Arrakark/BrightBoard/BOM Optimization.ods

 |  |  |  | Prototype |  | 100 Units
Quantity | Part Name | Manufacturer Part Number | Description | Unit Price | Extended Price | Replacement Part Number | Part Name | Unit Price | Extended Price | Purchase URL
56 | JE2835AWT-00-0000-000A0HG830ECT-ND | JE2835AWT-00-0000-000A0HG830E | CREE J SERIES JE2835 LIGHT EMITT | 0.042 | 2.352 | - | - | 0.02739 | 1.53384
56 | JE2835AWT-00-0000-000A0UF965ECT-ND | JE2835AWT-00-0000-000A0UF965E | CREE J SERIES JE2835 LIGHT EMITT | 0.043 | 2.408 | - | - | 0.02793 | 1.56408
3 | 399-9155-1-ND | C0805C104K9RACTU | CAP CER 0.1UF 6.3V X7R 0805 | 0.24 | 0.72 | C0805C104K5RACTU | CAP CER 0.1UF 50V X7R 0805 | 0.0020833 | 0.0062499 | https://www.ebay.com/itm/12-000pcs-3-Reels-KEMET-C0805C104K5RACTU-CAP-CER-0-1UF-50V-X7R-0805-ji-7c/273997252677
2 | 1276-2450-1-ND | CL21B104MBCNNNC | CAP CER 0.1UF 50V X7R 0805 | 0.041 | 0.082 | C0805C104K5RACTU | CAP CER 0.1UF 50V X7R 0805 | 0.0020833 | 0.0041666 | https://www.ebay.com/itm/12-000pcs-3-Reels-KEMET-C0805C104K5RACTU-CAP-CER-0-1UF-50V-X7R-0805-ji-7c/273997252677
1 | 490-14642-1-ND | GRM219C8YA225KE15D | CAP CER 2.2UF 35V X6S 0805 | 0.21 | 0.21 | GMK316B7225KLHT | CAP CER 2.2UF 35V X7R 1206 | 0.1286 | 0.1286 | https://www.digikey.ca/product-detail/en/taiyo-yuden/GMK316B7225KLHT/587-3370-1-ND/4157502
1 | 732-4986-1-ND | 150080VS75000 | LED GREEN CLEAR 0805 SMD | 0.17 | 0.17 | DNP | DNP | 0 | 0
1 | 609-3695-1-ND | 20021121-00010C4LF | CONN HEADER SMD 10POS 1.27MM | 0.84 | 0.84 | DNP | DNP | 0 | 0
1 | CP-102AH-ND | PJ-102AH | CONN PWR JACK 2X5.5MM SOLDER | 0.76 | 0.76 | - | - | 0.5428 | 0.5428
1 | 587-5797-1-ND | NRS5010T100MMGF | INDUCTOR SMD POWER, 10 UH20 %, T | 0.32 | 0.32 |  |  | 0.32 | 0.32
2 | DMN3404LDICT-ND | DMN3404L-7 | MOSFET N-CH 30V 5.8A SOT-23 | 0.39 | 0.78 |  |  | 0.39 | 0.78
1 | RNCP0805FTD1K00CT-ND | RNCP0805FTD1K00 | RES 1K OHM 1% 1/4W 0805 | 0.072 | 0.072 |  |  | 0.072 | 0.072
2 | A130471CT-ND | CRGP0805F330R | CRGP 0805 330R 1% | 0.22 | 0.44 |  |  | 0.22 | 0.44
1 | 296-41856-1-ND | TPS62177DQCR | IC REG BUCK 3.3V 500MA 10WSON | 1.65 | 1.65 |  |  | 1.65 | 1.65
2 | 1276-6170-1-ND | RUT2012FR100CS | RES 0.1 OHM 1% 1/4W 0805 | 0.3 | 0.6 |  |  | 0.3 | 0.6
3 | RMCF0805FT10K0CT-ND | RMCF0805FT10K0 | RES 10K OHM 1% 1/8W 0805 | 0.027 | 0.081 |  |  | 0.027 | 0.081
1 | RHM18BCCT-ND | MCR100JZHJ180 | RES SMD 18 OHM 5% 1W 2512 | 0.27 | 0.27 |  |  | 0.27 | 0.27
2 | RMCF0805FT100KCT-ND | RMCF0805FT100K | RES 100K OHM 1% 1/8W 0805 | 0.027 | 0.054 |  |  | 0.027 | 0.054
4 | 1276-2405-1-ND | CL21A106KQCLRNC | CAP CER 10UF 6.3V X5R 0805 | 0.085 | 0.34 |  |  | 0.085 | 0.34
1 | E73-2G4M04S1B | E73-2G4M04S1B | NRF52832 E73-2G4M04S Bluetooth module | 3.1 | 3.1 | - | - | 2.7 | 2.7
1 | - | - | 24V 3A Power Supply (Generic, 5.5x2.1mm Plug) | 9.39 | 9.39 |  |  | 9.39 | 9.39
1 | PCB | PCB | JLCPCB (Order of 10) | 5.238 | 5.238 | - | - | 5 | 5
1 | Plastic Shroud |  |  | 0 | 0 |  |  |  | 0
8 | M4 Nut |  |  | 0 | 0 |  |  |  | 0
8 | M4 Bolt |  |  | 0 | 0 |  |  |  | 0
1 | Baseplate |  |  | 0 | 0 |  |  |  | 0
1 | Tripod Tilt Adapter |  |  | 0 | 0 |  |  |  | 0
1 | Tripod |  |  | 0 | 0 |  |  |  | 0
 |  |  |  | Cost per board | 29.877 |  |  | Cost per board | 25.4767365
