Arrakark/BrightBoard/BrightBoard1/CUI_PJ-102A.step

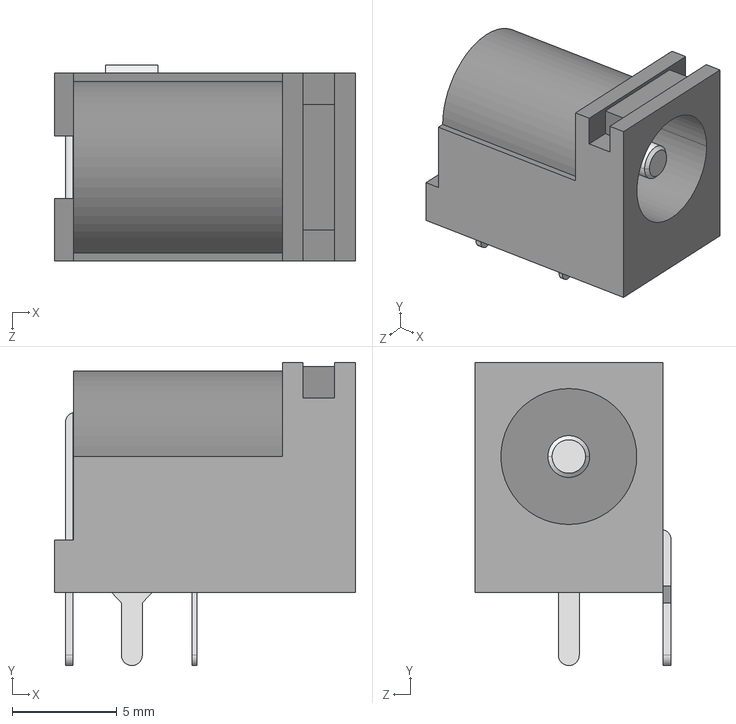
[picture p1: CAD file, 2019-09-11]
BrightBoard1/CUI_PJ-102A.step
14.4 x 14.5 x 9.40 mm
