Arrakark/BrightBoard/BrightBoard1/BrightBoard1.step

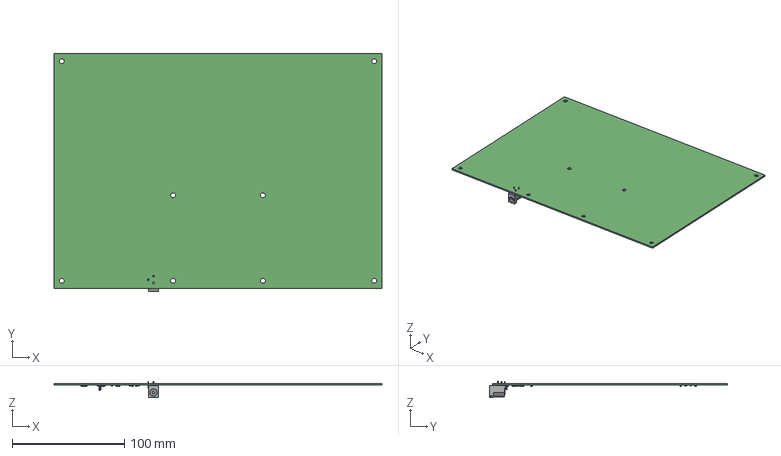
[picture p2: CAD file, 2019-09-11]
BrightBoard1/BrightBoard1.step
292.1 x 212.2 x 14.5 mm
