Arrakark/BrightBoard/BrightBoard1/BrightBoard1.kicad_pcb

## KiCad design BrightBoard1/BrightBoard1.kicad_pcb (2019-09-11)

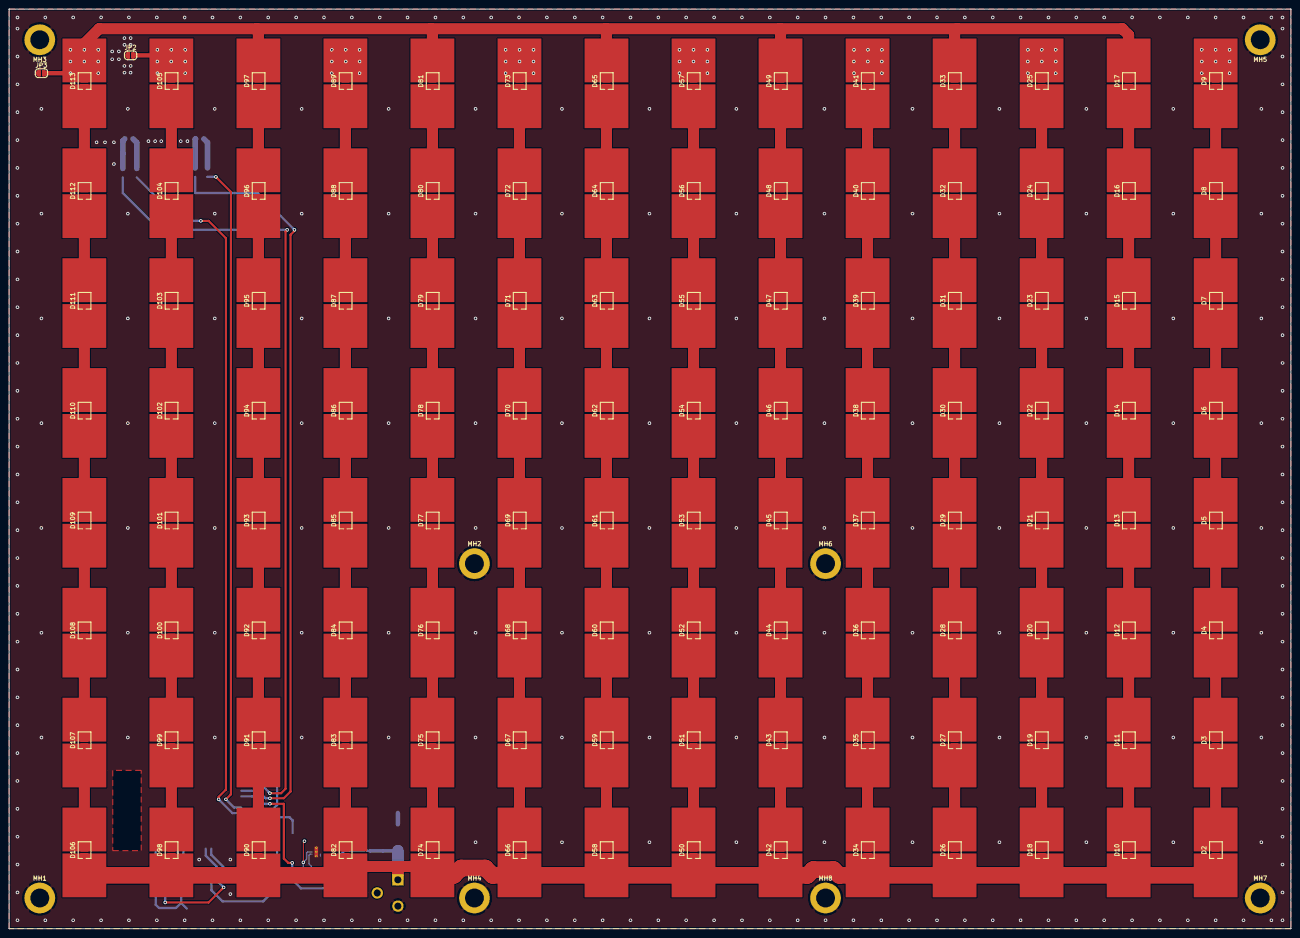
[picture p3: board BrightBoard1.kicad_pcb from above]

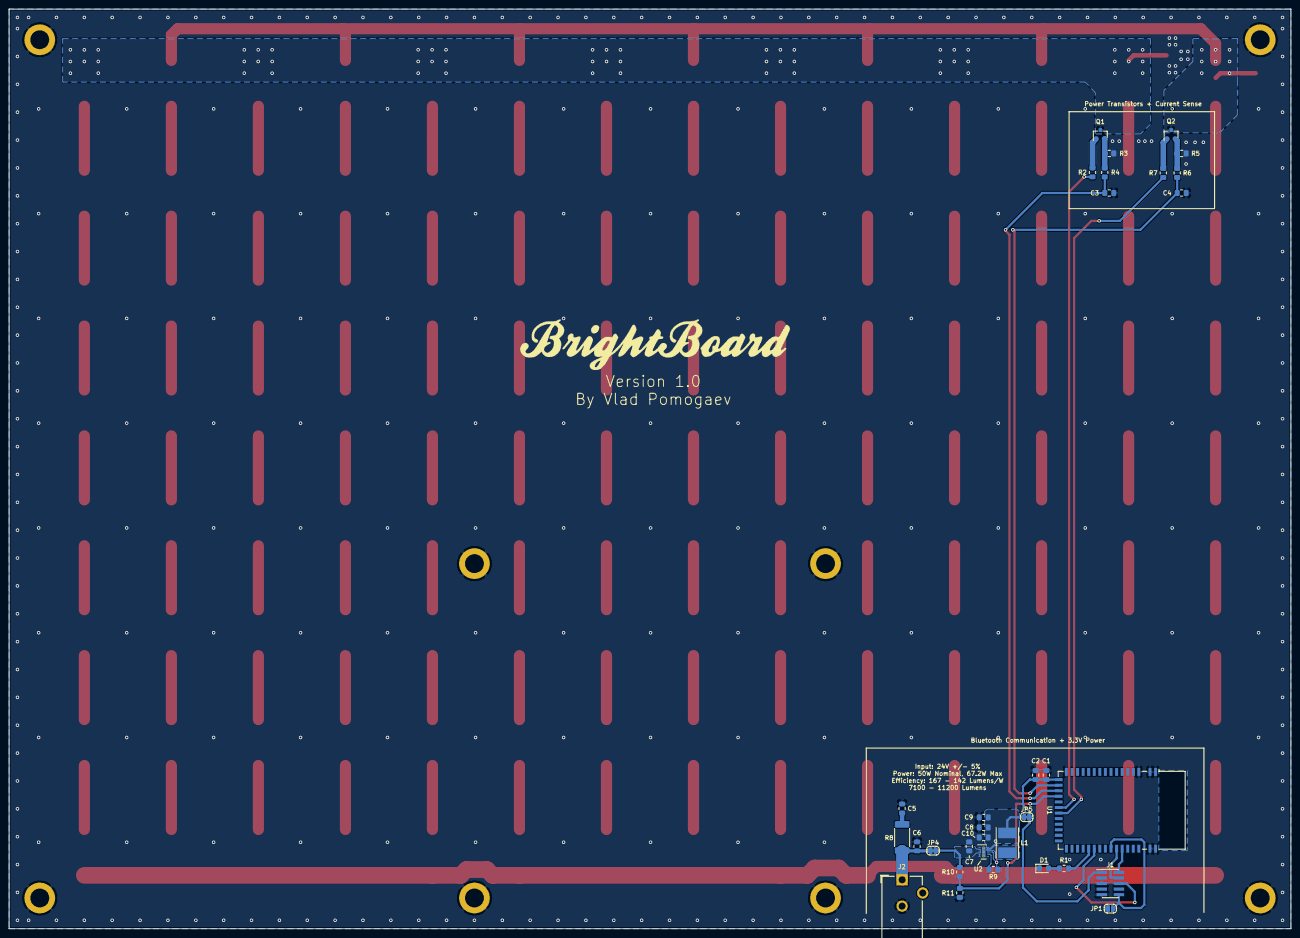
[picture p4: board BrightBoard1.kicad_pcb from below]

Board: 2 copper layers, 292.1 x 209.6 mm, 154 parts (32 on the bottom side), 123 nets.

Parts:
C1, C8, C9, C10: 10uF 6.3V; C_0805_2012Metric_Pad1.15x1.40mm_HandSolder
C2, C3, C4: 100nF 6.3V; C_0805_2012Metric_Pad1.15x1.40mm_HandSolder
C5, C6: 100nF 30V; C_0805_2012Metric_Pad1.15x1.40mm_HandSolder
C7: 2.2uF 30V; C_0805_2012Metric_Pad1.15x1.40mm_HandSolder
D1: GREEN_LED; LED_0805_2012Metric_Pad1.15x1.40mm_HandSolder
D2, D3, D4, D5, D6, D7, D8, D9, D18, D19, D20, D21, D22, D23, D24, D25, D34, D35, D36, D37, D38, D39, D40, D41, D50, D51, D52, D53, D54, D55, D56, D57, D66, D67, D68, D69, D70, D71, D72, D73, D82, D83, D84, D85, D86, D87, D88, D89, D98, D99, D100, D101, D102, D103, D104, D105: LED_1; 2835_LED
D10, D11, D12, D13, D14, D15, D16, D17, D26, D27, D28, D29, D30, D31, D32, D33, D42, D43, D44, D45, D46, D47, D48, D49, D58, D59, D60, D61, D62, D63, D64, D65, D74, D75, D76, D77, D78, D79, D80, D81, D90, D91, D92, D93, D94, D95, D96, D97, D106, D107, D108, D109, D110, D111, D112, D113: LED_2; 2835_LED
J1: Conn_ARM_JTAG_SWD_10; PinHeader_2x05_P1.27mm_Vertical_SMD
J2: VIN_JACK; BarrelJack_CUI_PJ-102AH_Horizontal
JP1: RESET; SolderJumper-2_P1.3mm_Open_RoundedPad1.0x1.5mm
JP2: STRIP_1_BYPASS; SolderJumper-2_P1.3mm_Open_RoundedPad1.0x1.5mm
JP3: STRIP_2_BYPASS; SolderJumper-2_P1.3mm_Open_RoundedPad1.0x1.5mm
JP4: IN_JUMPER; SolderJumper-2_P1.3mm_Bridged_RoundedPad1.0x1.5mm
JP5: OUT_JUMPER; SolderJumper-2_P1.3mm_Bridged_RoundedPad1.0x1.5mm
L1: 10uH 124mOhm; L_Taiyo-Yuden_NR-50xx_HandSoldering
MH1, MH2, MH3, MH4, MH5, MH6, MH7, MH8: M4; MountingHole_4.3mm_M4_ISO14580_Pad
Q1, Q2: DMN3404L; SOT-23
R1: 1k00; R_0805_2012Metric_Pad1.15x1.40mm_HandSolder
R2, R7: 330R; R_0805_2012Metric_Pad1.15x1.40mm_HandSolder
R3, R5: 0R10; R_0805_2012Metric_Pad1.15x1.40mm_HandSolder
R4, R6, R11: 10K0; R_0805_2012Metric_Pad1.15x1.40mm_HandSolder
R8: 18R 1W; R_2512_6332Metric_Pad1.52x3.35mm_HandSolder
R9: 100k; R_0805_2012Metric_Pad1.15x1.40mm_HandSolder
R10: 100K; R_0805_2012Metric_Pad1.15x1.40mm_HandSolder
U1: E73-2G4M04S-52832; E73-2G4M04S
U2: TPS62177DQC; WSON-10-1EP_2x3mm_P0.5mm_EP0.84x2.4mm_ThermalVias

Connections:
+3V3: C1.1, C2.1, J1.1, JP5.2, U1.16
/HEARTBEAT: R1.1, U1.32
/LEDs/STRIP_1_RETURN: D9.1, D25.1, D41.1, D57.1, D73.1, D89.1, D105.1, JP2.2, Q1.3
/LEDs/STRIP_2_RETURN: D17.1, D33.1, D49.1, D65.1, D81.1, D97.1, D113.1, JP3.2, Q2.3
/STRIP_1_AI: C3.1, R4.1, U1.18
/STRIP_1_EN: R2.2, U1.21
/STRIP_2_AI: C4.1, R6.1, U1.17
/STRIP_2_EN: R7.2, U1.22
/SWDCLK: J1.4, U1.37
/SWDIO: J1.2, U1.38
/TRACEDATA[0]: J1.6, U1.33
/VCC_AI: R10.2, R11.1, U1.19
/~RESET: J1.10, JP1.2, U1.36
GND: C1.2, C2.2, C3.2, C4.2, C5.2, C6.2, C7.2, C8.2, C9.2, C10.2, D1.1, J1.3, J1.5, J1.9, J2.2, JP1.1, JP2.1, JP3.1, MH1.1, MH2.1, MH3.1, MH4.1, MH5.1, MH6.1, MH7.1, MH8.1, R3.2, R5.2, R11.2, U1.0, U1.1, U1.2, U1.15, U1.42, U1.43, U2.1, U2.4, U2.5, U2.6, U2.11
unnamed: C5.1, R8.2
unnamed: C7.1, JP4.2, R10.1, U2.2, U2.3
unnamed: C8.1, C9.1, C10.1, JP5.1, L1.2, R9.1, U2.8, U2.10
unnamed: D1.2, R1.2
unnamed: D2.1, D3.2
unnamed: D3.1, D4.2
unnamed: D4.1, D5.2
unnamed: D5.1, D6.2
unnamed: D6.1, D7.2
unnamed: D7.1, D8.2
unnamed: D8.1, D9.2
unnamed: D10.1, D11.2
unnamed: D11.1, D12.2
unnamed: D12.1, D13.2
unnamed: D13.1, D14.2
unnamed: D14.1, D15.2
unnamed: D15.1, D16.2
unnamed: D16.1, D17.2
unnamed: D18.1, D19.2
unnamed: D19.1, D20.2
unnamed: D20.1, D21.2
unnamed: D21.1, D22.2
unnamed: D22.1, D23.2
unnamed: D23.1, D24.2
unnamed: D24.1, D25.2
unnamed: D26.1, D27.2
unnamed: D27.1, D28.2
unnamed: D28.1, D29.2
unnamed: D29.1, D30.2
unnamed: D30.1, D31.2
unnamed: D31.1, D32.2
unnamed: D32.1, D33.2
unnamed: D34.1, D35.2
unnamed: D35.1, D36.2
unnamed: D36.1, D37.2
unnamed: D37.1, D38.2
unnamed: D38.1, D39.2
unnamed: D39.1, D40.2
unnamed: D40.1, D41.2
unnamed: D42.1, D43.2
unnamed: D43.1, D44.2
unnamed: D44.1, D45.2
unnamed: D45.1, D46.2
unnamed: D46.1, D47.2
unnamed: D47.1, D48.2
unnamed: D48.1, D49.2
unnamed: D50.1, D51.2
unnamed: D51.1, D52.2
unnamed: D52.1, D53.2
unnamed: D53.1, D54.2
unnamed: D54.1, D55.2
unnamed: D55.1, D56.2
unnamed: D56.1, D57.2
unnamed: D58.1, D59.2
unnamed: D59.1, D60.2
unnamed: D60.1, D61.2
unnamed: D61.1, D62.2
unnamed: D62.1, D63.2
unnamed: D63.1, D64.2
unnamed: D64.1, D65.2
unnamed: D66.1, D67.2
unnamed: D67.1, D68.2
unnamed: D68.1, D69.2
unnamed: D69.1, D70.2
unnamed: D70.1, D71.2
unnamed: D71.1, D72.2
unnamed: D72.1, D73.2
unnamed: D74.1, D75.2
unnamed: D75.1, D76.2
unnamed: D76.1, D77.2
unnamed: D77.1, D78.2
unnamed: D78.1, D79.2
unnamed: D79.1, D80.2
unnamed: D80.1, D81.2
unnamed: D82.1, D83.2
unnamed: D83.1, D84.2
unnamed: D84.1, D85.2
unnamed: D85.1, D86.2
unnamed: D86.1, D87.2
unnamed: D87.1, D88.2
unnamed: D88.1, D89.2
unnamed: D90.1, D91.2
unnamed: D91.1, D92.2
unnamed: D92.1, D93.2
unnamed: D93.1, D94.2
unnamed: D94.1, D95.2
unnamed: D95.1, D96.2
unnamed: D96.1, D97.2
unnamed: D98.1, D99.2
unnamed: D100.1, D101.2
unnamed: D99.1, D100.2
unnamed: D101.1, D102.2
unnamed: D102.1, D103.2
unnamed: D103.1, D104.2
unnamed: D104.1, D105.2
unnamed: D106.1, D107.2
unnamed: D107.1, D108.2
unnamed: D108.1, D109.2
unnamed: D109.1, D110.2
unnamed: D110.1, D111.2
unnamed: D111.1, D112.2
unnamed: D112.1, D113.2
unnamed: L1.1, U2.9
unnamed: Q1.1, R2.1
unnamed: Q1.2, R3.1, R4.2
unnamed: Q2.1, R7.1
unnamed: Q2.2, R5.1, R6.2
unnamed: R9.2, U2.7
VCC: C6.1, D2.2, D10.2, D18.2, D26.2, D34.2, D42.2, D50.2, D58.2, D66.2, D74.2, D82.2, D90.2, D98.2, D106.2, J2.1, JP4.1, R8.1
