Arrakark/BrightBoard/Prototype Board Validation.ods

Voltage (V) | Current (A) | Power (W) | Power/LED (W) | Current/String (A) | Lumens | Temperature © | Delta Temperature ©
23.4 | 1.5 | 35.1 | 0.31 | 0.107 | 5967 | 47 | 25
24 | 1.73 | 41.52 | 0.37 | 0.124 | 7058 | 50 | 28
25 | 2.28 | 57 | 0.51 | 0.163 | 9690 | 51 | 29
25.5 | 2.61 | 66.555 | 0.59 | 0.186 | 11314 | 57 | 35
