Arrakark/BrightBoard/(commit log)

2019-08-12 Renamed all LEDs
    [BrightBoard1.kicad_pcb]
2019-08-12 Added mounting holes
    [BrightBoard1.kicad_pcb]
2019-09-02 Layed out LEDs, 3.3v regulator; going to change it to a larger package
    [BrightBoard1.kicad_pcb]
2019-09-08 Moving over?
    [BrightBoard1.kicad_pcb, BrightBoard1.sch, PowerSupply.sch]
2019-09-09 Routed all traces; need to finish ESD ring
    [BrightBoard1.kicad_pcb]
2019-09-26 Ready for first build
    [BOM Optimization.ods]
2019-09-27 Validated new prototype board
    [BOM Optimization.ods, Prototype Board Validation.ods]
